studleydooright/annunciator_panel/images/brake_up-canopy-closed.jpg

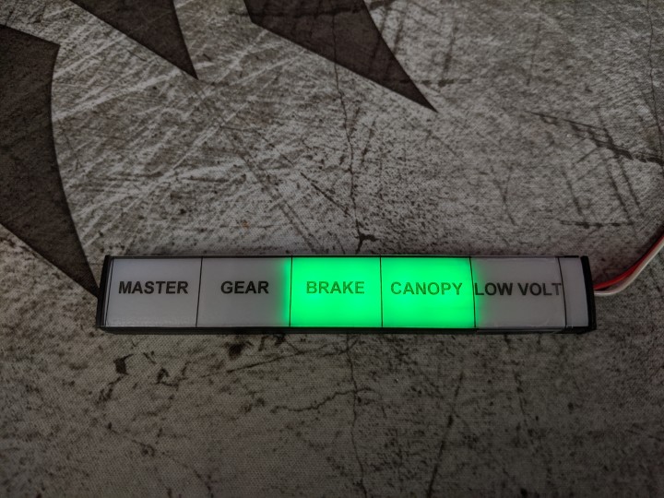
images/brake_up-canopy-closed.jpg
