studleydooright/annunciator_panel/images/high_throttle-brake_up-canopy_warning.jpg

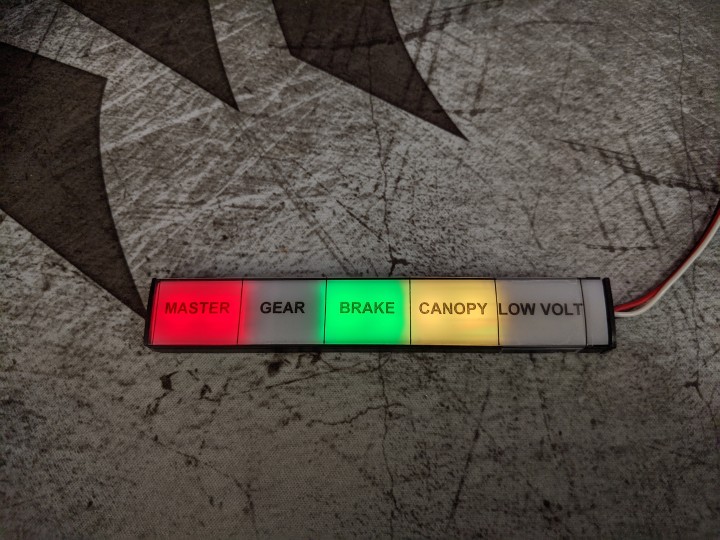
images/high_throttle-brake_up-canopy_warning.jpg
