studleydooright/annunciator_panel/images/high_throttle-brake_warning-canopy_closed.jpg

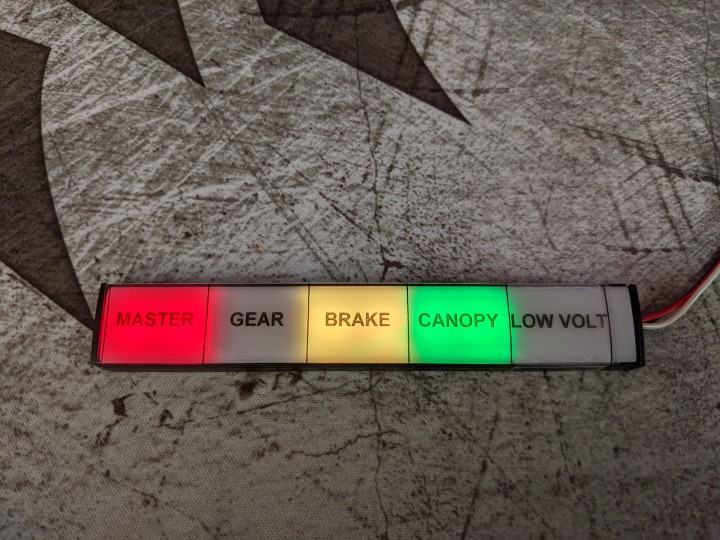
images/high_throttle-brake_warning-canopy_closed.jpg
