studleydooright/annunciator_panel/(commit log)

2019-12-31 Update README.md
    Clarification on the LED Light strip density
2020-01-12 comments concerning the MAP sensor voltage range
2020-01-12 fixed typo in MAP sensor voltage conversion for serial monitor debugging
    [annunciator.ino]
2020-07-08 refined the throttle min/max
2020-07-14 updated the throttle thresholds and the alerting logic for throttle position in relation to gear down switch.
2020-07-16 Further adjustments of the Throttle threshold and altering logic concerning switch positioning.
2020-07-28 Adjustment of the mix/max throttle (MAP) values
2020-08-15 Enabled the Canopy functions and refined the throttle min/max values
2020-08-15 Added landing brake and landing gear check; if the brake is out and the gear still up, issue a warning (not in landing config)
    [annunciator.ino]
2021-06-12 Update annunciator.ino
    Averaging throttleVal to dampen reading
2021-06-23 Update annunciator.ino
    Refining the THROTTLE_LOW and reading avg count...
2022-05-31 Update annunciator.ino
    Dropped THROTTLE_LOW from 260 to 220 to prevent the Landing Gear warning when in cruise flight or descent
    [annunciator.ino]
2022-11-16 additional audio files
    Added separate Boost Pump state audio files; on and off...
